siyouluo/SoundCollector/Reference/SignalAmplifier/readme.md

# 小信号放大

# LM358
[LM358 100倍增益 信号放大模块](https://pan.baidu.com/s/1ntuPVV7)  
由Multisim仿真可知, 该电路通带增益约100倍, 通带频率在24.75Hz\~8.76KHz之间,
可以实现语音信号的放大.  
后续可以调节R7, R9, 将电压调整到0\~3.3V之间, 但这要考虑实际中咪头输出电压

# MAX9814
MAX9814是市面上常见的一款高品质的麦克风放大器, 支持40dB, 50dB
或60dB的可控电压增益. 内部提供2V低噪声麦克风电压偏置,内部含有AGC,
确保不会在增益过大时发生削波.  
对于本实验而言, 肯定是不允许使用这款芯片的, 但可以作为参考  
更多[参考资料](./MAX9814)
