siyouluo/SoundCollector/Reference/单片机最小系统/Readme.md

# stm32f103c8t6

[YD01-STM32F103C8T6核心板资料](https://pan.baidu.com/s/1mh197YS)
[STM32/STM8微控制器](https://www.stmcu.com.cn/)
