siyouluo/SoundCollector/Images/PCB板.jpg.jpg

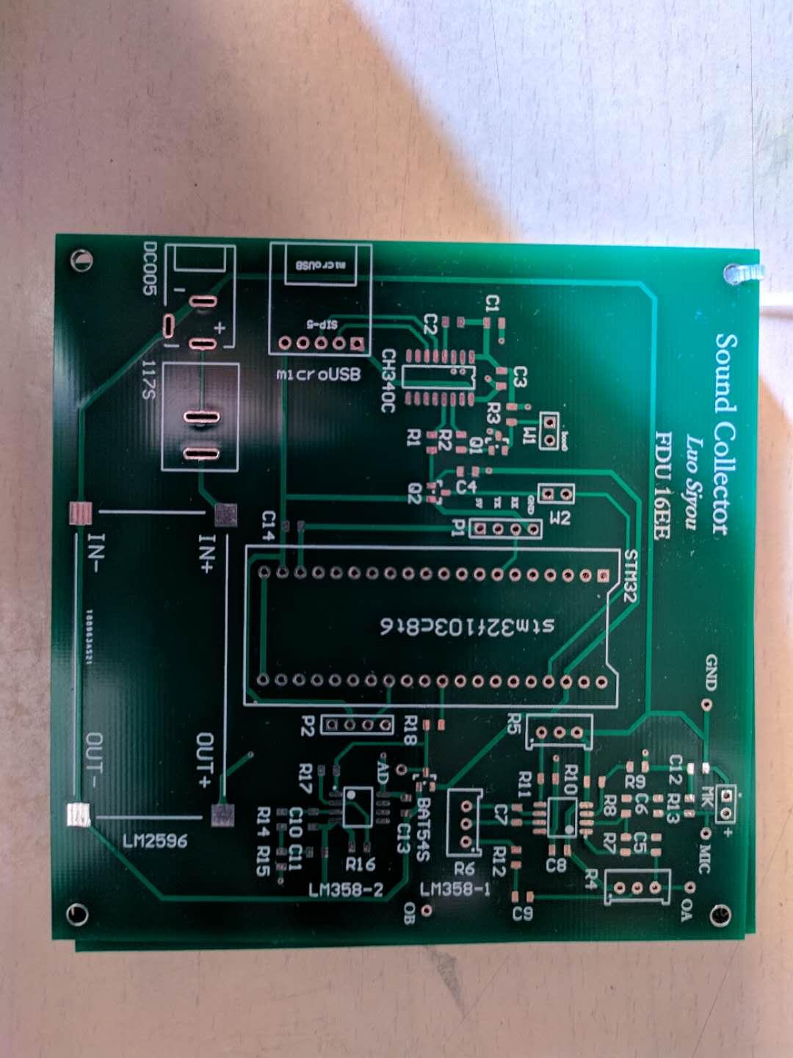
Images/PCB板.jpg.jpg
