siyouluo/SoundCollector/Images/成果实物图2.jpg.jpg

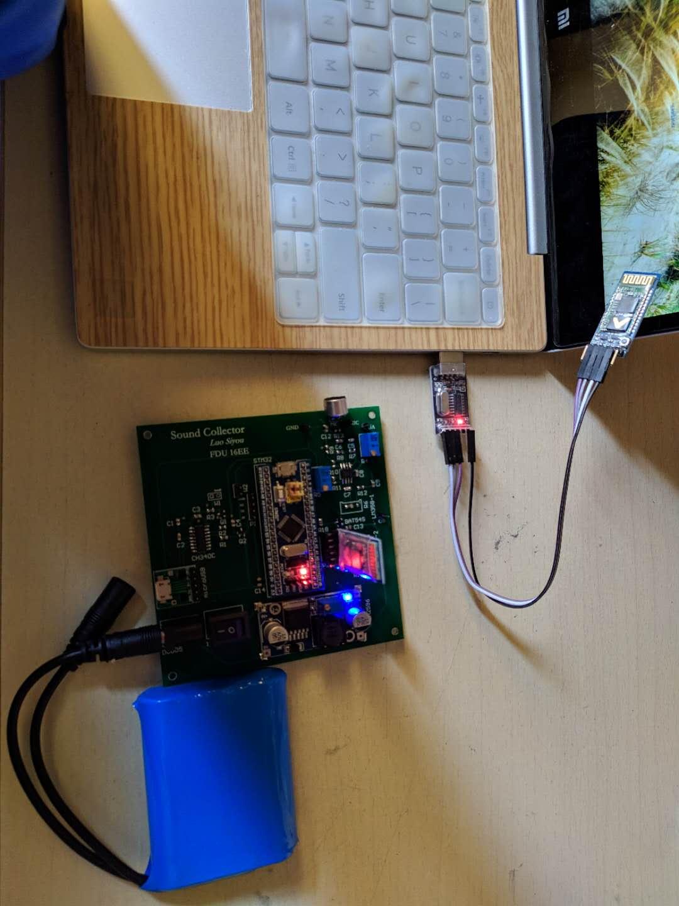
Images/成果实物图2.jpg.jpg
