siyouluo/SoundCollector/MultisimProject/二阶低通滤波上截止频率.png

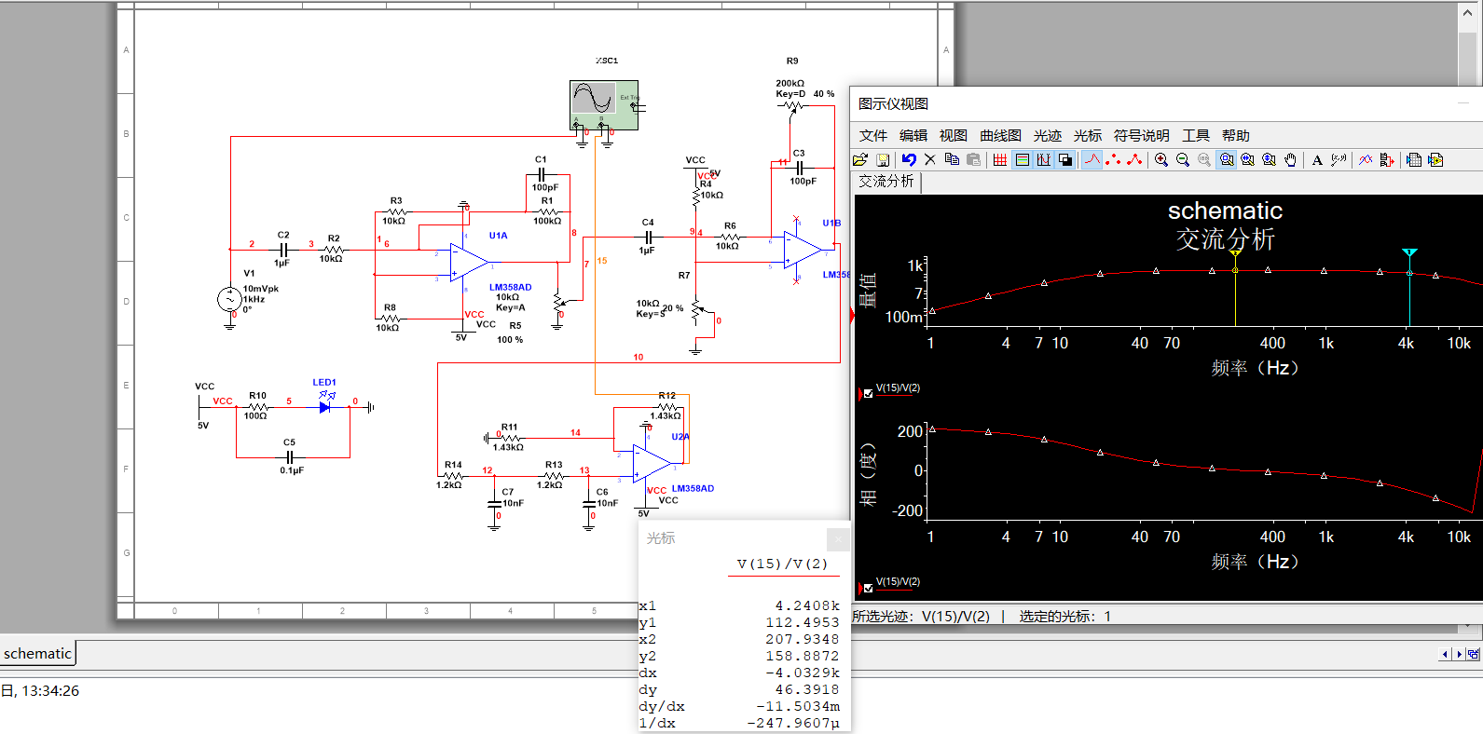
MultisimProject/二阶低通滤波上截止频率.png
