siyouluo/SoundCollector/MultisimProject/交流仿真上截止频率.png

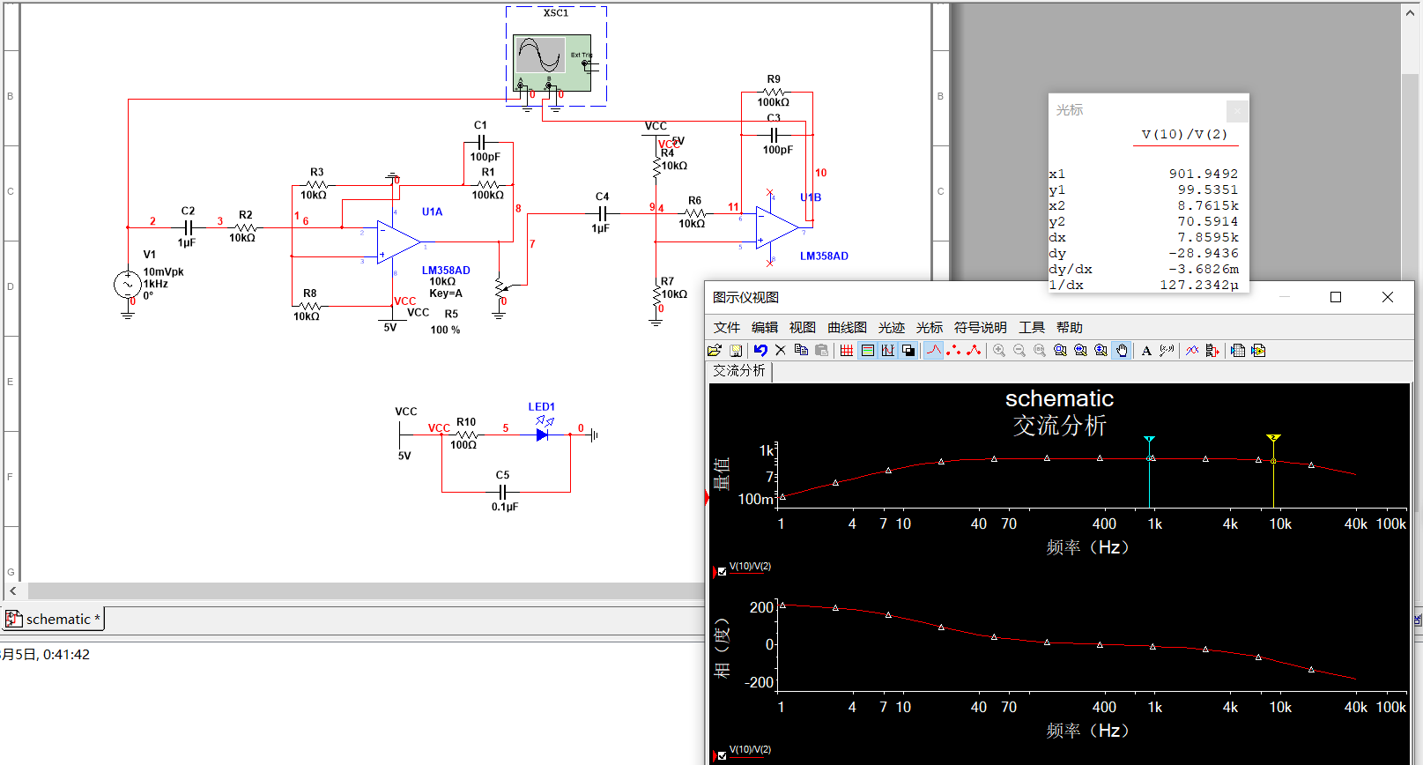
MultisimProject/交流仿真上截止频率.png
