siyouluo/SoundCollector/MultisimProject/交流仿真下截止频率.png

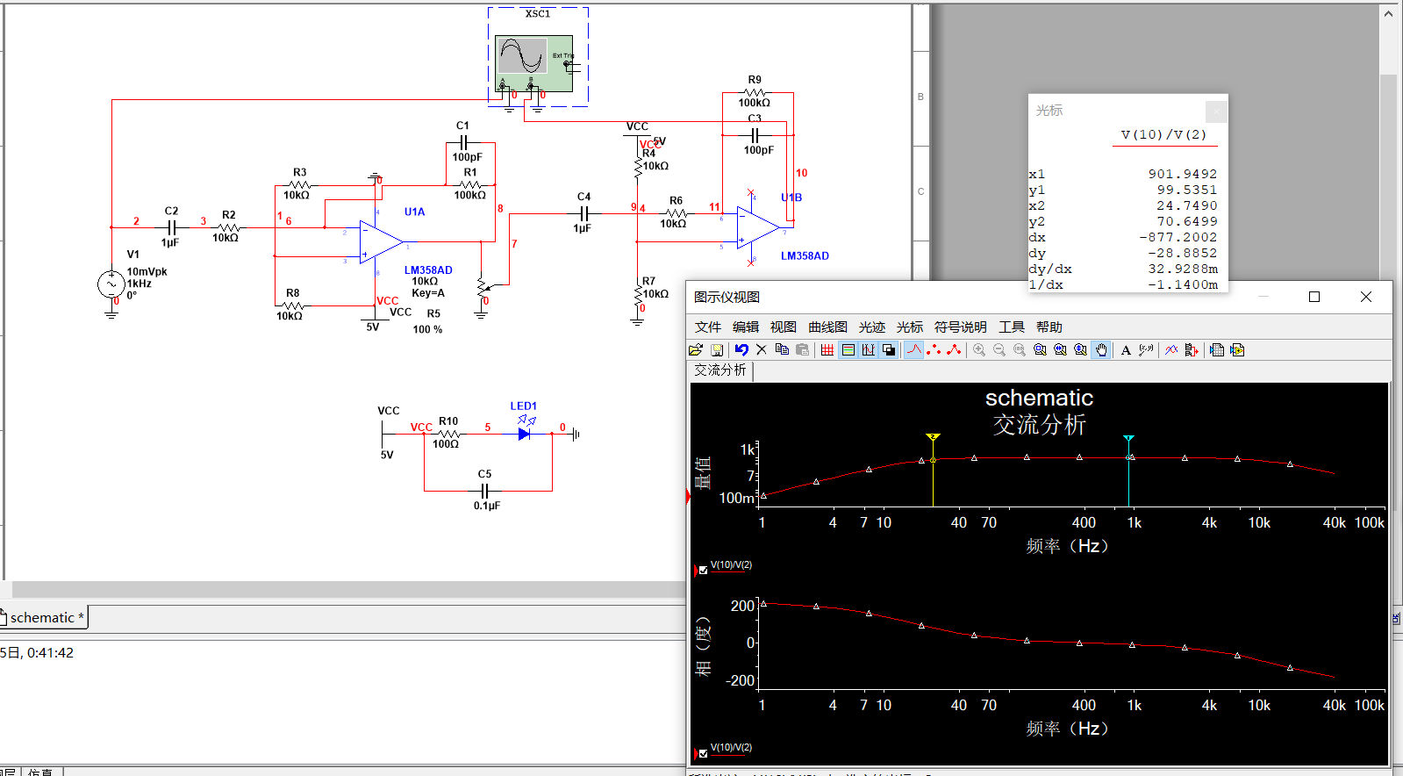
MultisimProject/交流仿真下截止频率.png
