siyouluo/SoundCollector/Reference/3296W电位计/3296W电位计产品参数.png

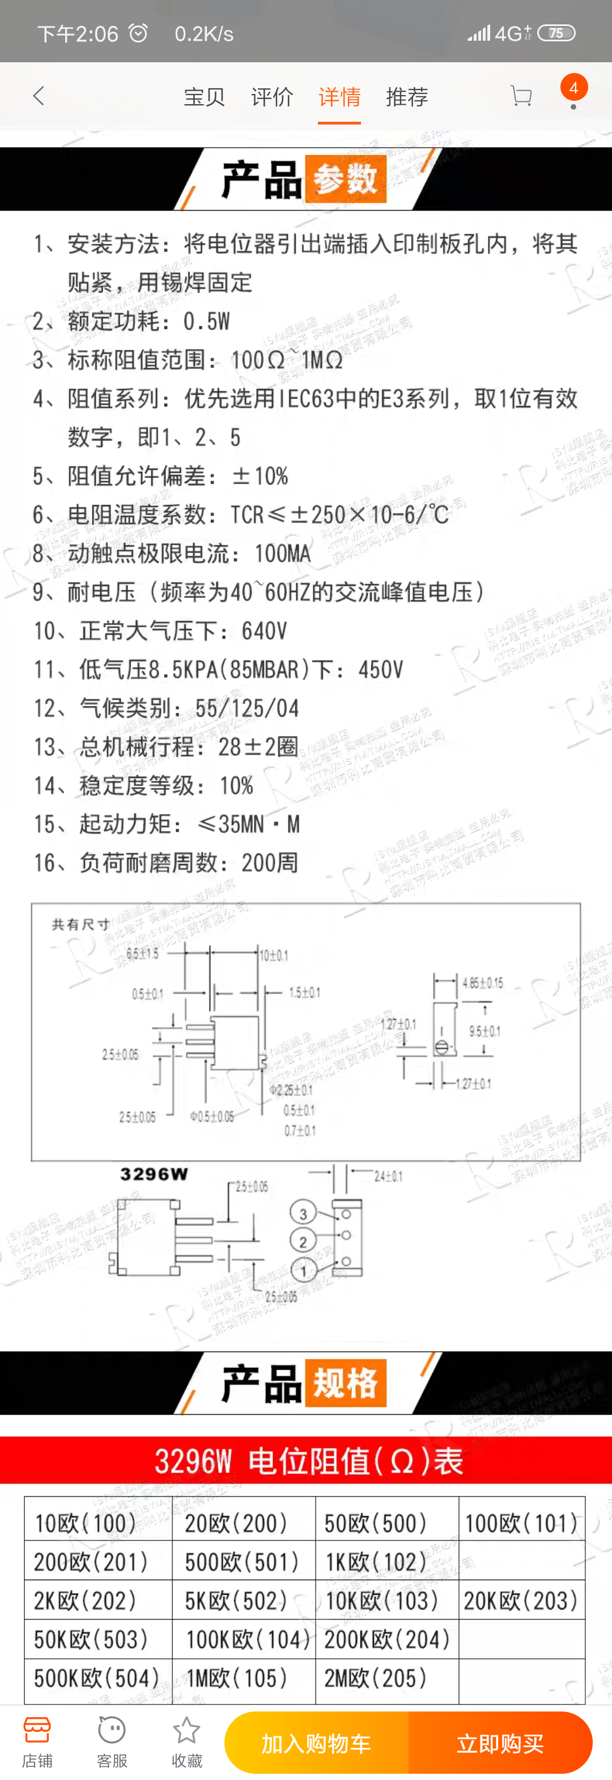
Reference/3296W电位计/3296W电位计产品参数.png
