siyouluo/SoundCollector/Reference/SignalAmplifier/MAX9814/MAX9814模块实物图正面.jpg

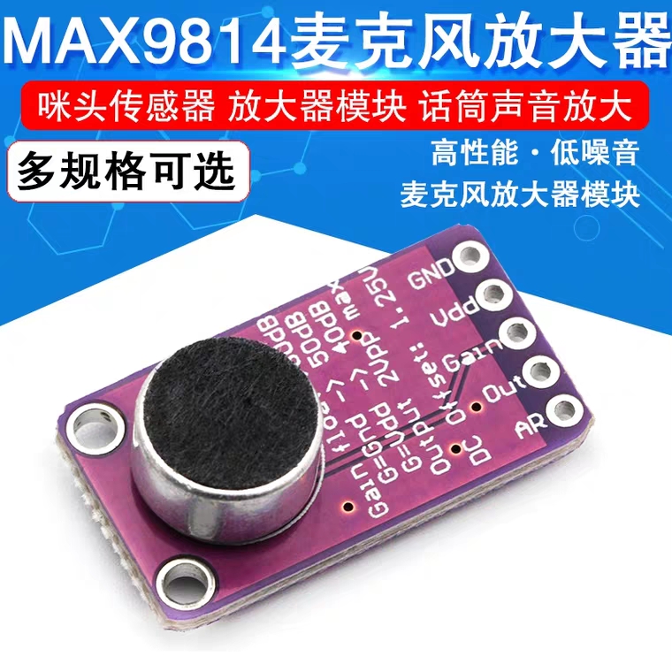
Reference/SignalAmplifier/MAX9814/MAX9814模块实物图正面.jpg
