siyouluo/SoundCollector/Reference/SignalAmplifier/MAX9814/MAX9814模块实物图背面.jpg

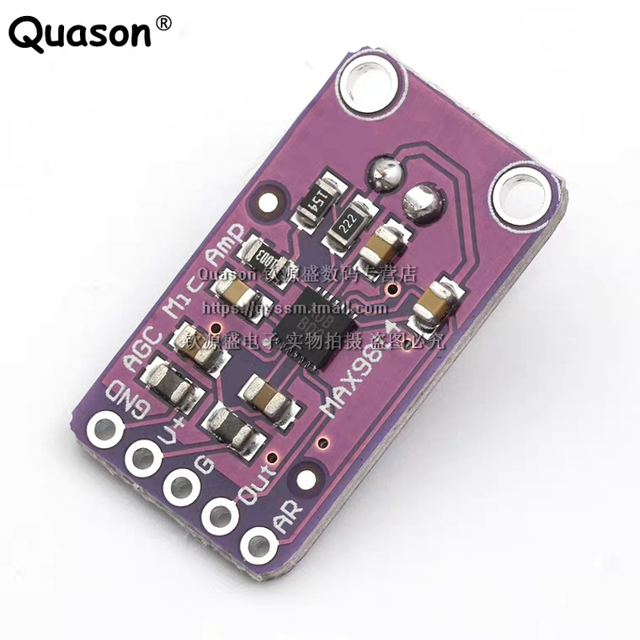
Reference/SignalAmplifier/MAX9814/MAX9814模块实物图背面.jpg
