siyouluo/SoundCollector/Reference/单片机最小系统/stm32f103c8t6.png

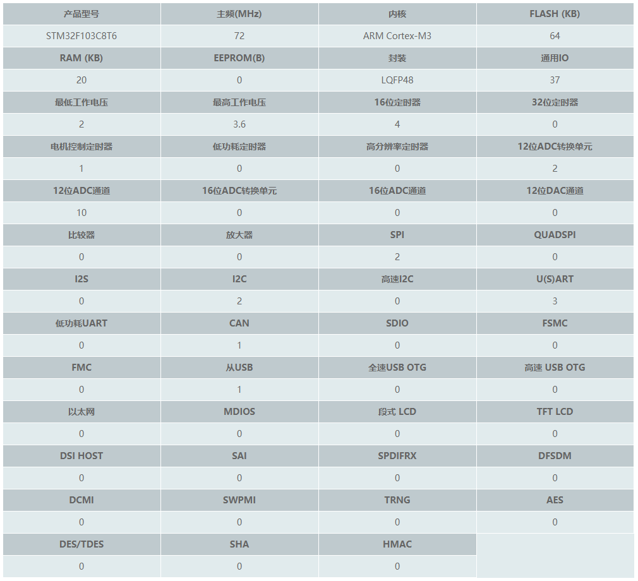
Reference/单片机最小系统/stm32f103c8t6.png
