siyouluo/SoundCollector/Reference/咪头/参考电路.png

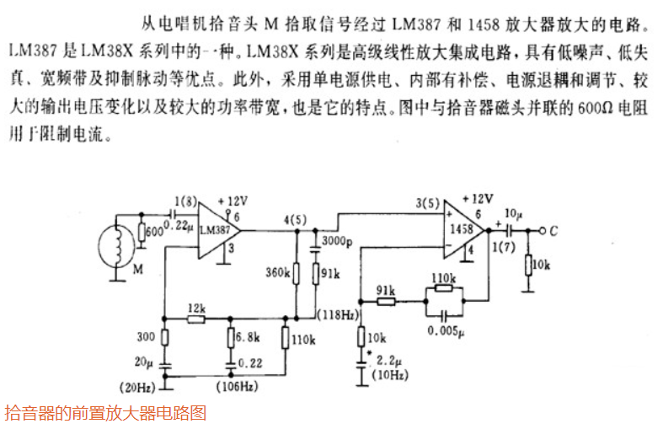
Reference/咪头/参考电路.png
