siyouluo/SoundCollector/Reference/咪头/咪头.jpg

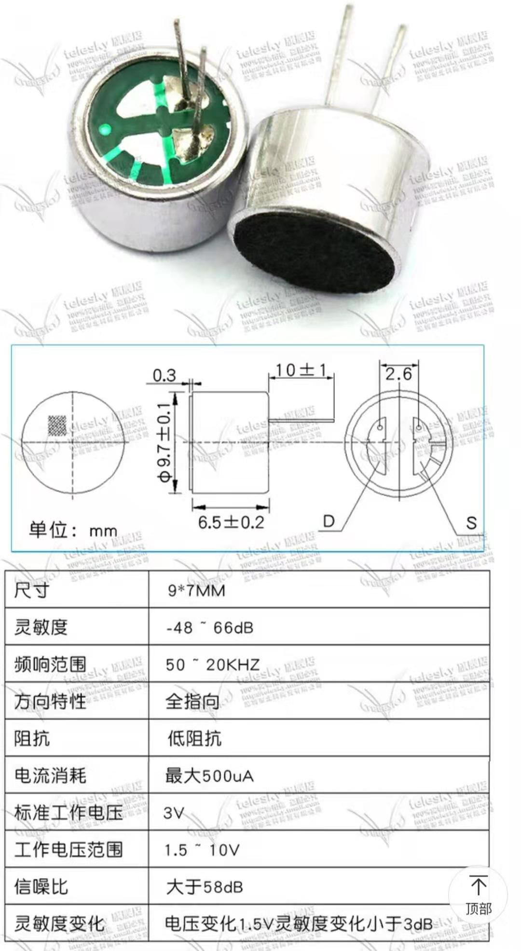
Reference/咪头/咪头.jpg
