siyouluo/SoundCollector/AltiumDesignerProject/Project Outputs for SoundCollector/rawScalePCB.pdf

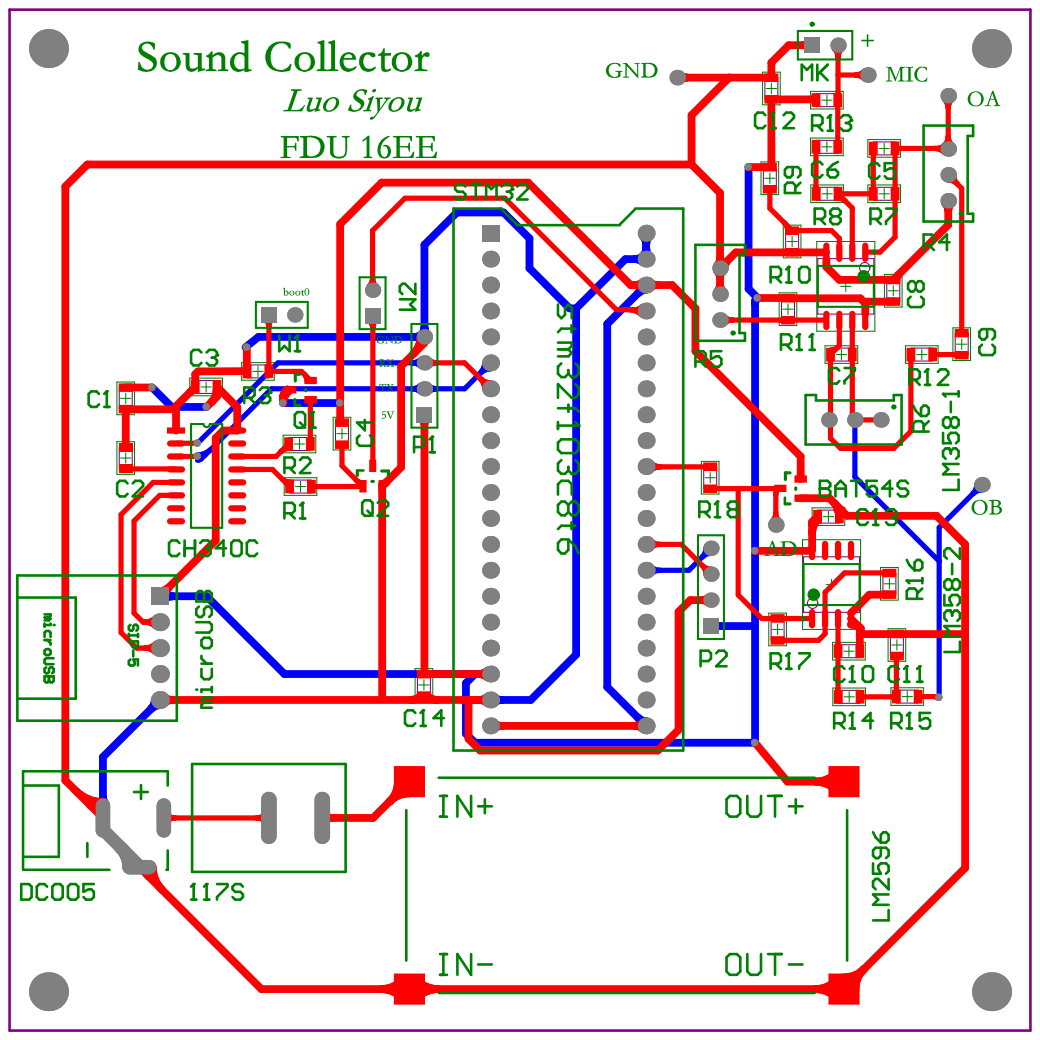
[picture p62: page 1]
