siyouluo/SoundCollector/AltiumDesignerProject/Project Outputs for SoundCollector/SoundCollector.pdf

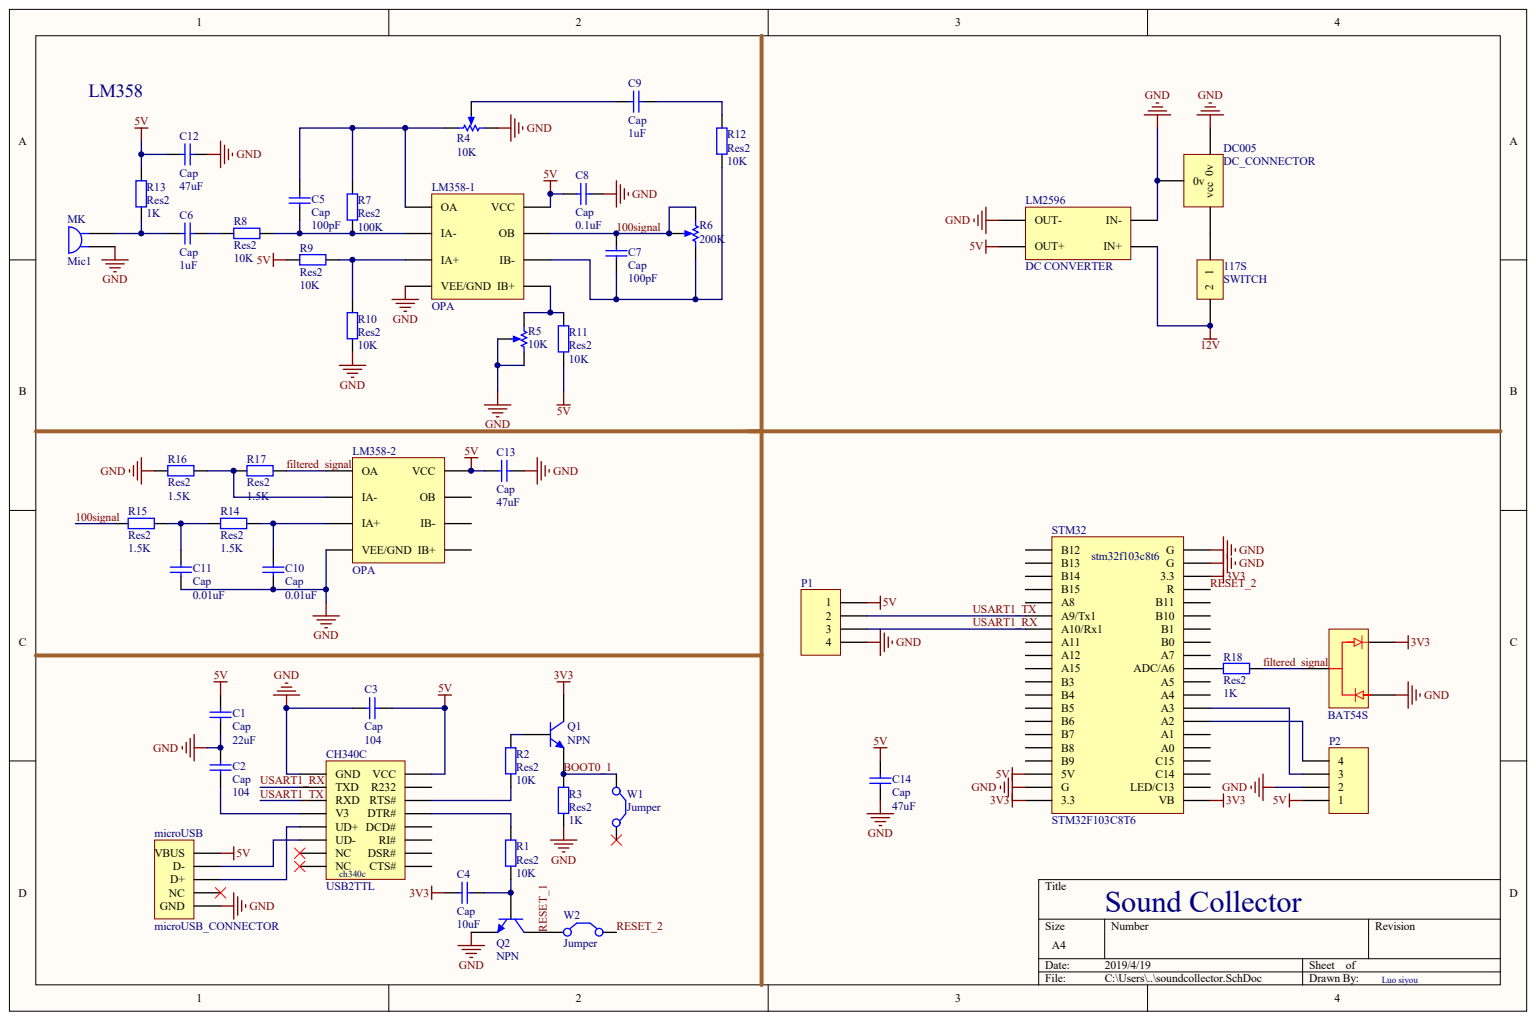
[picture p63: page 1]

C7
Cap 100pF

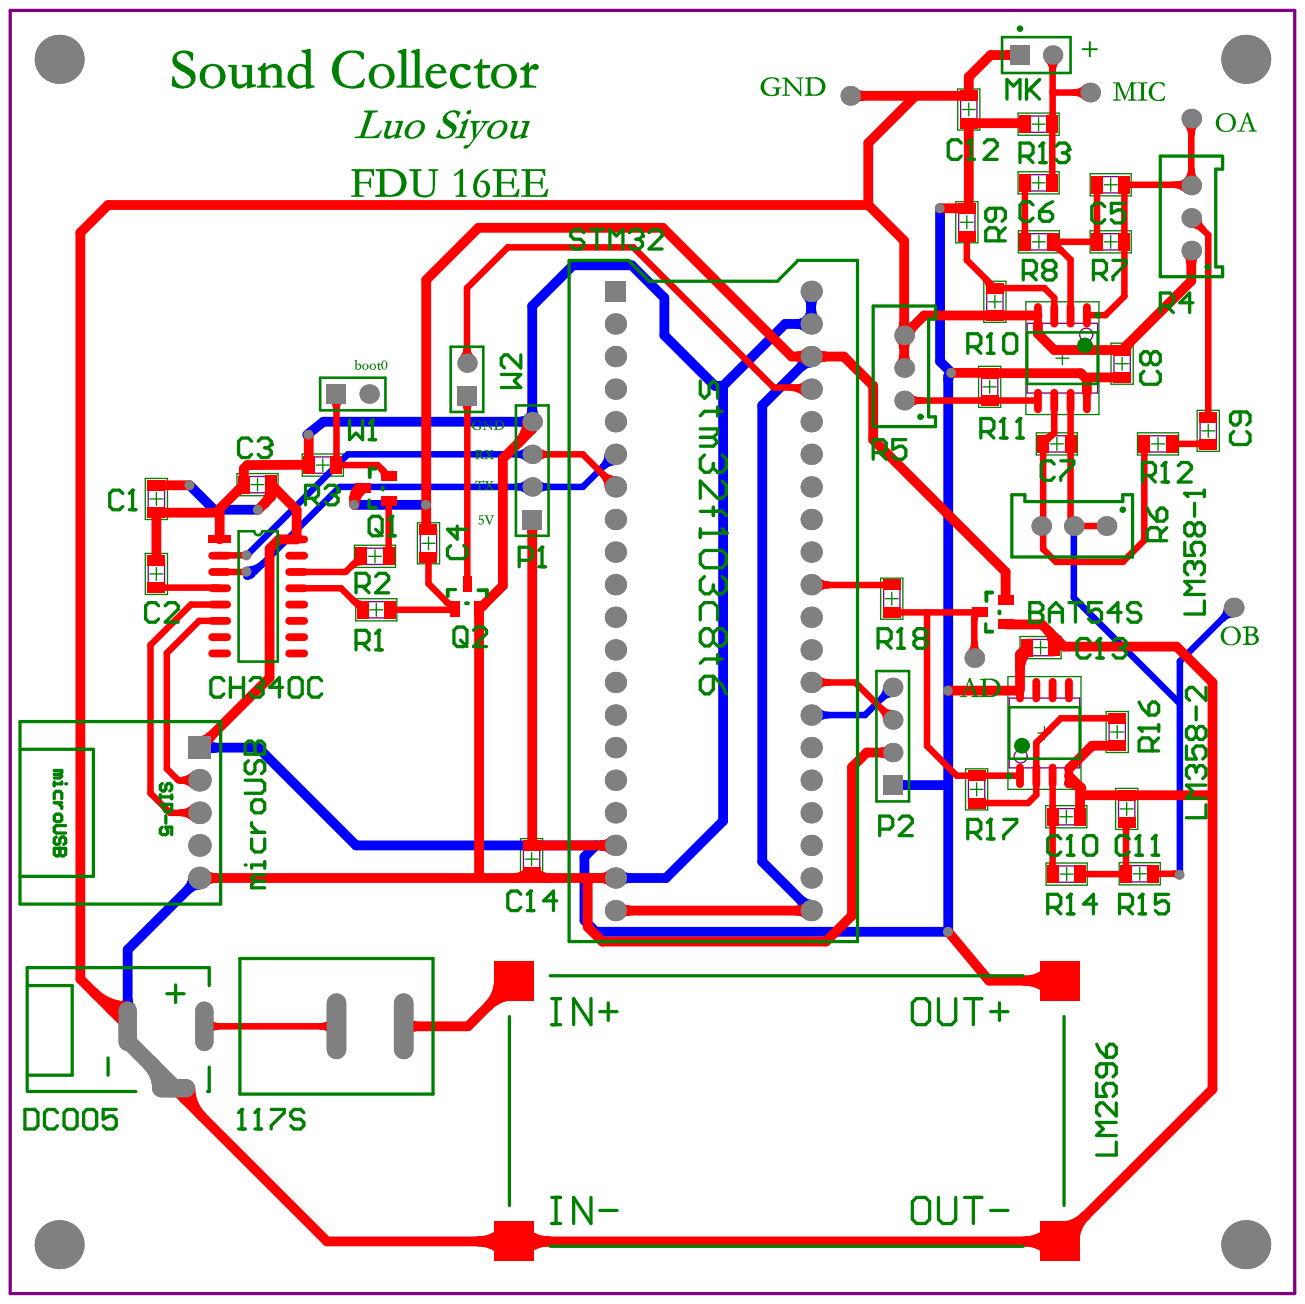
[picture p64: page 2]
