siyouluo/SoundCollector/(list of files, drawings)

Other design files:
AltiumDesignerProject/SoundCollector.PrjPcb
AltiumDesignerProject/soundcollector.SchDoc
MultisimProject/schematic.ms12
