siyouluo/SoundCollector/KeilProject/Public/usart1.h

#ifndef _USART_H
#define _USART_H

#include "system.h"
#include "stdio.h"

extern void USART1_Init(u32 baud);
extern int fputc(int ch, FILE *p);
#define USART1_MAX_QUEUE_BUF_SIZE 100	//USART1串口缓冲区大小，单位：字节

extern uint8_t USART1_RECEIEVE_QUEUE_BUF[USART1_MAX_QUEUE_BUF_SIZE];//USART1串口缓冲区
extern uint8_t USART1_QUEUE_REAR;//串口缓冲区队列尾，入队位置
extern uint8_t USART1_QUEUE_FRONT;//串口缓冲区队列首，出队位置
extern uint8_t USART1_QUEUE_FULL(void);
extern uint8_t USART1_QUEUE_EMPTY(void);
extern uint8_t USART1_PUSH_QUEUE(uint8_t ch);
extern uint8_t USART1_POP_QUEUE(void);
extern void USART1_WriteByte(uint8_t ch);
extern void USART1_WriteBytes(uint8_t n, uint8_t *p);


#endif
