siyouluo/SoundCollector/KeilProject/App/IndicatorLight.h

#ifndef _INDICATORLIGHT_H
#define _INDICATORLIGHT_H

#include "system.h"
/*  LED时钟端口、引脚定义 */
#define LED_PORT 			GPIOC   
#define LED_PIN 			(GPIO_Pin_13)
#define LED_PORT_RCC		RCC_APB2Periph_GPIOC


#define led PCout(13)


void LED_Init(void);

#endif
