siyouluo/SoundCollector/(commit log)

2019-03-05 完成小信号放大电路设计
    [schematic.ms12]
2019-03-05 add DC bias and Amplify
    [schematic.ms12]
2019-03-06 low pass filter
    [schematic.ms12]
2019-03-11 完成简易上位机
2019-03-13 完成Altium Designer原理图绘制
    [SoundCollector.PrjPcb, soundcollector.SchDoc]
2019-03-16 初步完成PCB板绘制
    [SoundCollector.PrjPcb, soundcollector.SchDoc]
2019-03-19 稍加完善GUI界面
    [soundcollector.SchDoc]
2019-03-21 实时绘图 ./scripts/gui.py
2019-03-22 整理部分文档
    [soundcollector.SchDoc]
2019-03-23 音频文件读写与播放
2019-03-28 add BOM in AltiumDesignerProject dir
    [SoundCollector.PrjPcb, schematic.ms12, soundcollector.SchDoc]
2019-03-30 修复gui.py中无法接收'\x00'的问题
    [SoundCollector.PrjPcb, soundcollector.SchDoc]
2019-04-16 进一步完善上位机
    [SoundCollector.PrjPcb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]
2019-04-27 修复已知bug，完成PCB板焊接调试，优化上位机
    [schematic.ms12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]
2019-05-03 添加实验报告
    [SoundCollector.PrjPcb, soundcollector.SchDoc]
